tomkooij/Tantillus/Rendering/Tantillus 2.11.jpg

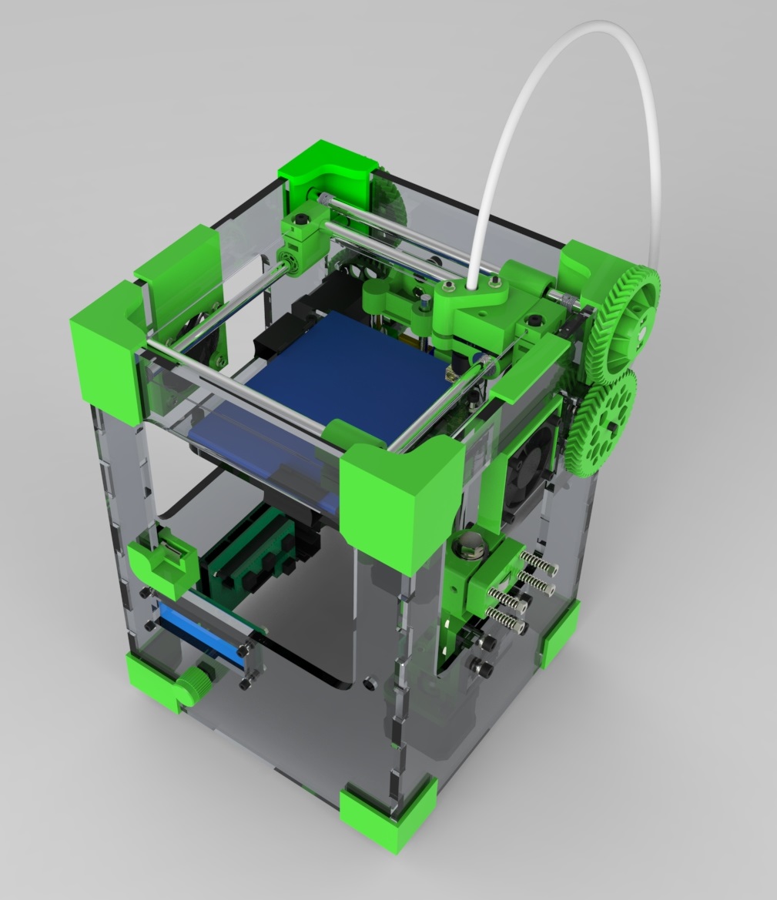
Rendering/Tantillus 2.11.jpg
