tomkooij/Tantillus/Rendering/Tantillus 2.10.jpg

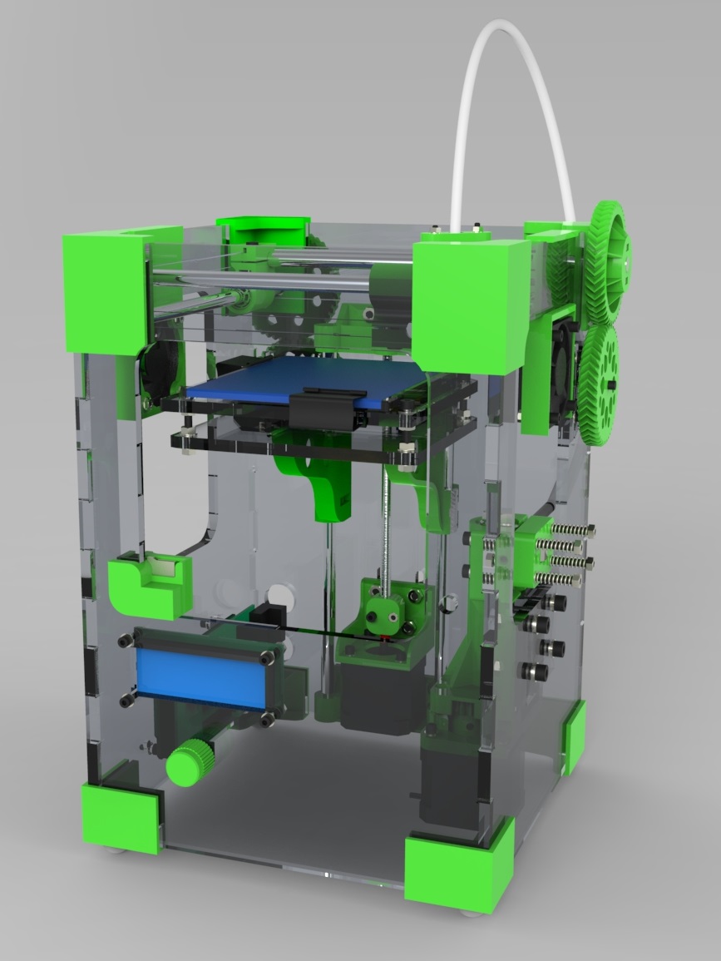
Rendering/Tantillus 2.10.jpg
