tomkooij/Tantillus/README.md

Tantillus
=========

Source and production files for Tantillus 3D Printer Metric edition. By: github.com/willworkforplastic
