tomkooij/Tantillus/READ ME.txt

Tantillus Laser Cutter Metric Edition Solidworks 2012 Model V0.5
See http://www.tantillus.org/ or http://forums.reprap.org/list.php?279 for more info.

*********************************************************************
THIS IS ALWAYS A WORK IN PROGRESS. 
THERE ARE PROBABLY THINGS WRONG WITH HACKED CONFIGS, ALLWAYS CHECK BEFORE USING
THE STANDARD CONFIG HAS BEEN USED MANY TIMES NOW SO IS RELATIVELY SAFE
*********************************************************************

If you print off this model and things are wrong do not blame me!

Check each part for configurations. 

Some parts have 3d print configurations, and laser cutter offset configurations.

Top Level Assembly has display states for removing covers. Also Configurations for various hacks I have done to my machine.
Many configs now through models!

Cheers
Will Work For Plastic
(And Paintballs)

"Living isn't a simple thing" - Everclear

An now for the boring Rev history:

V1.0
X/Y bars now 170mm long were 175mm, to prevent spectra line rubbing
Fixed hot end double up on overall Bom
Removed redundant bulldog clips
Changed nuts in carriage assembly to M3, were M4
Fixed X/Y end STL's so thru hole is actually thru
Changed hex holes in extruder body to 7.5mm were 8/7.2mm

V0.9
Added BOM/Assembly drawings (finally)
Added much more to hacked config (not tested properly yet)
Could not save off an overall hacked version STL (SW crashing when saving off......)

V0.8
Updated Lower Bed Mounting Holes to be in same position as orginal (imperial design) to improve cross compatiblity
Moved position of bull dog clip to avoid one hitting hand on fan when putting on
Moved laser cutting hack files to hack folder to avoid confusion
Added another laser cutting hack file for future heated bed trials

V0.7
Mainly fixed model to be backwards compatible with orginal imperial design
Fixed front pannel bearing pitch mistake (off by 0.25mm)
Increase XY ends shaft hole size to 8.2mm as per orginal design
Tapered wire holes in upper cariage as per orginal design
XY ends updated to new design as per orginal design
Slightly adjusted printed bush dims to match orginal design
Added SD ramps holder hack
Added Voltage/Current meter hack
Added Die Spring Hack
Added missing fastner for Audrino
Drawings to come in next rev

V0.6
Fixed stepper lenght from 48mm to 40mm
Updated bed to be the same as orginal Tantillus design
Added draft to endstop switch
Added representation of bowden tube
Tidied up github repo

V0.5
Fixes as per Sublime Found:
Lower Corners height reduced from 40.5mm to 30.5mm
Updated XY ends to latest rev from Sublime
Updated upper gears to latest rev from Sublime
Changed front pannel fillment hole from 6mm to 8mm
Changed Z-lift to be correct way around and removed redundant plate
Changed Z-axis shaft hole in Z upper bracket from 6mm to 8mm

V0.4
Changed holes in XY ends from 8.2mm to 8.0mm
Added missing features in extruder body
Correct extruder spring posistions
Removed plattern springs
Added Glass and bull dog clips
Added Fans in
Added all gears in supplied by eric (Chur Eric)
Added electronic assembly in supplied by eric (Chur Chur eric)
Completed adding fastners
Fan mount snap hocks profile changed to allow easier snap on
Slight issue with top part of carriage not clamping hot end well. That is blind hole slightly too deep. Reduced clearance.

V0.3 
Intial release into the wild
