tomkooij/Tantillus/Rendering/Tantillus 2.13.jpg

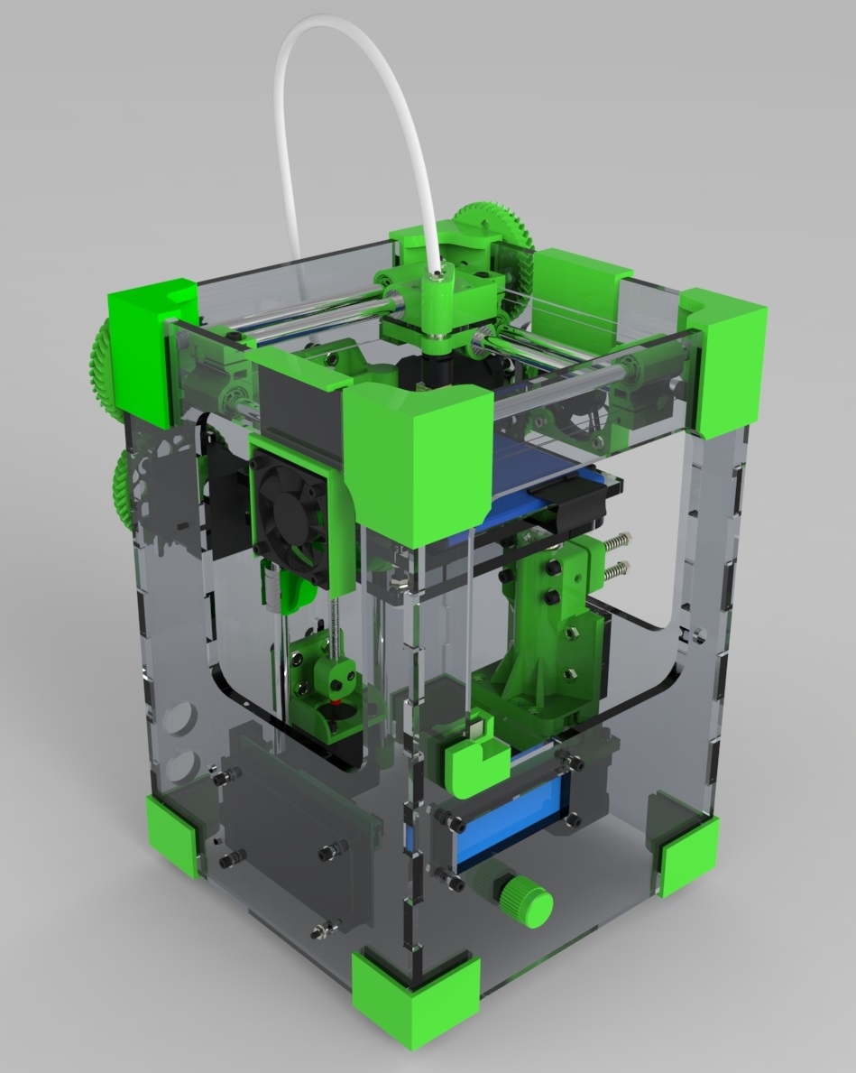
Rendering/Tantillus 2.13.jpg
