tomkooij/Tantillus/Rendering/Tantillus 2.14.jpg

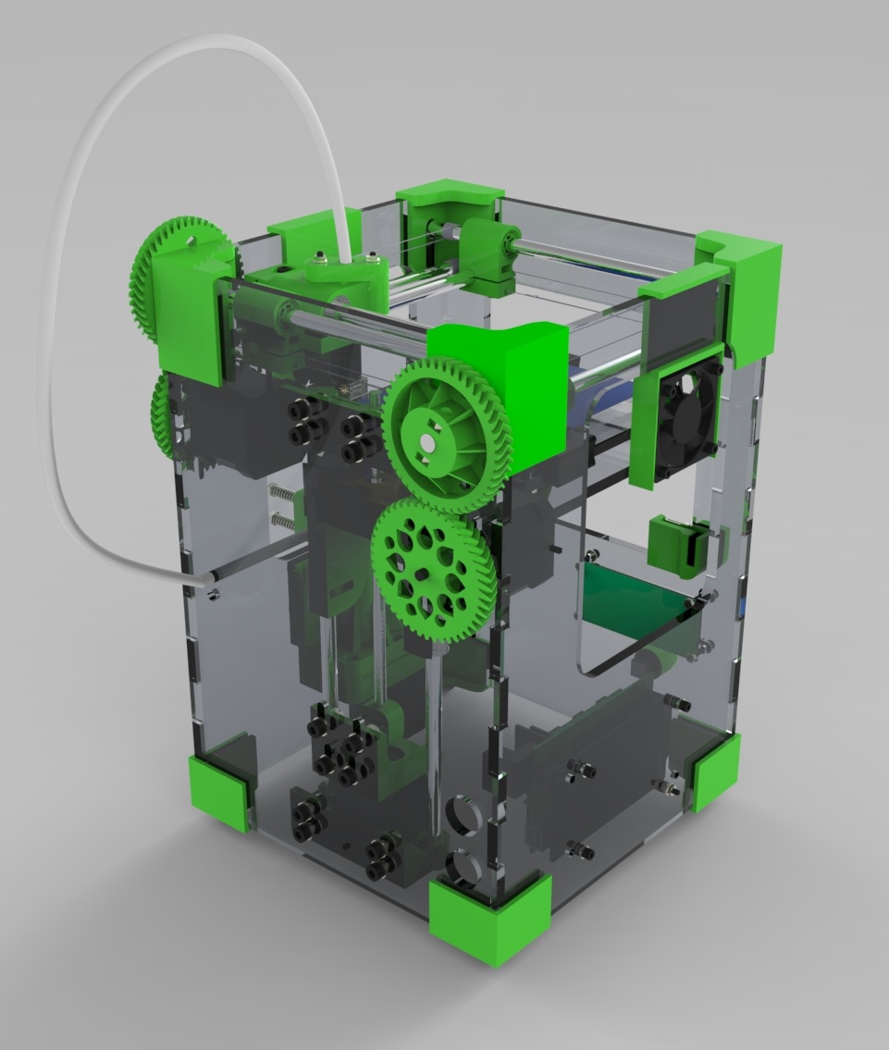
Rendering/Tantillus 2.14.jpg
