tomkooij/Tantillus/Rendering/Tantillus 2.15.jpg

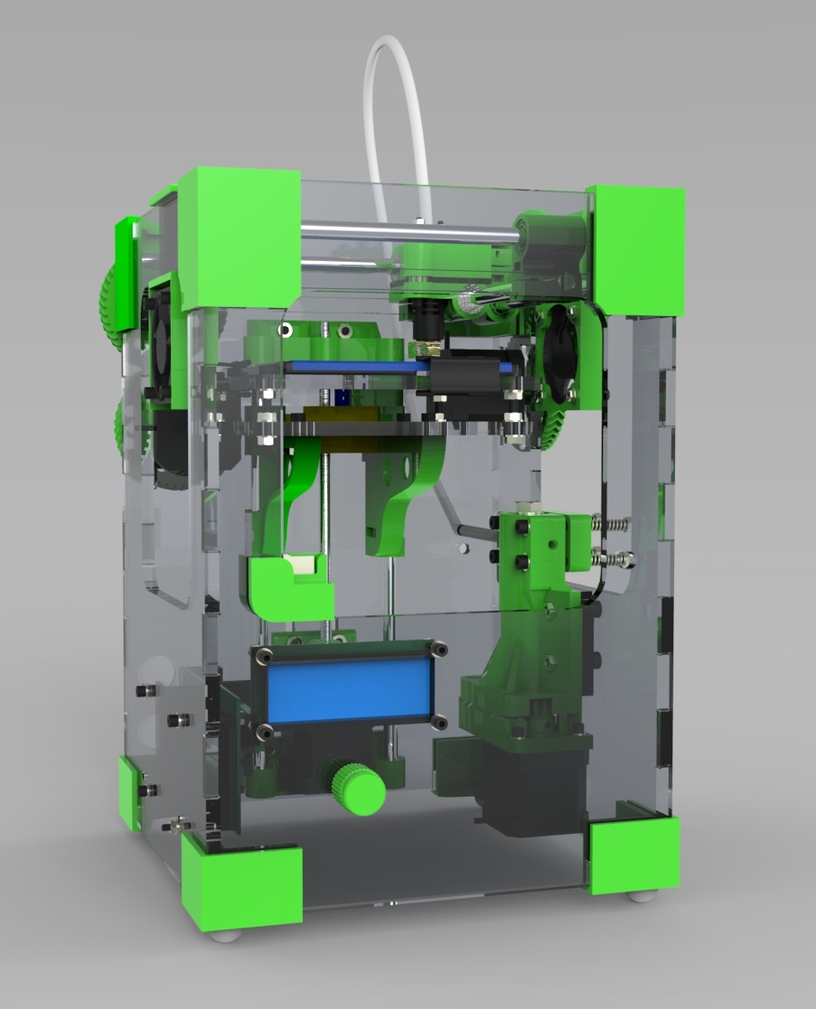
Rendering/Tantillus 2.15.jpg
