tomkooij/Tantillus/Production Files/Axis/XY_end_left.STL

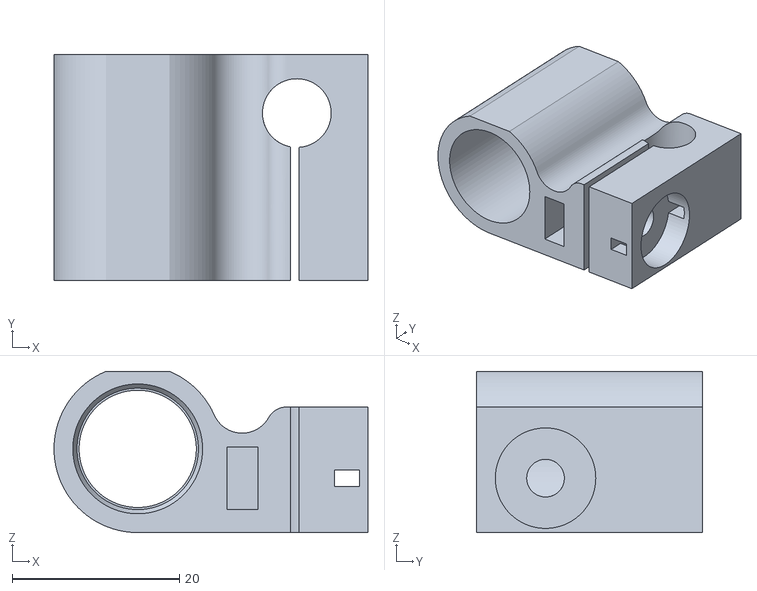
[picture p6: CAD file, 2013-09-08]
Production Files/Axis/XY_end_left.STL
37.5 x 27.0 x 19.3
