tomkooij/Tantillus/Production Files/Corners/Corner_top_rear_right.STL

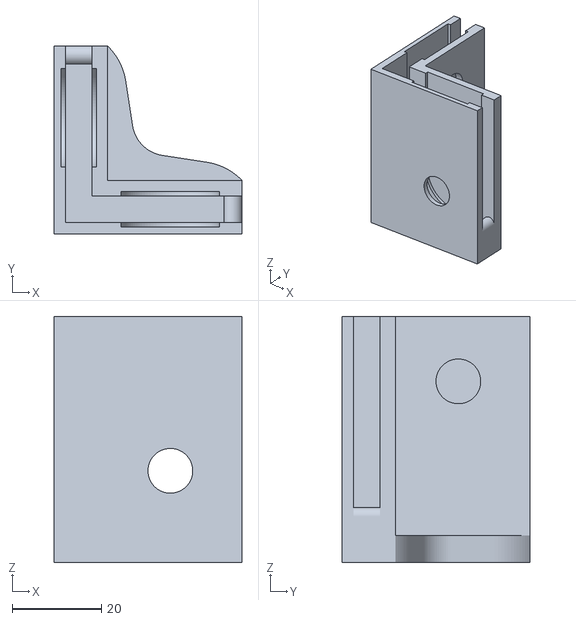
[picture p7: CAD file, 2012-12-14]
Production Files/Corners/Corner_top_rear_right.STL
42.0 x 42.0 x 55.0
