tomkooij/Tantillus/Production Files/Extras/50mm_fanmount_(LC).STL

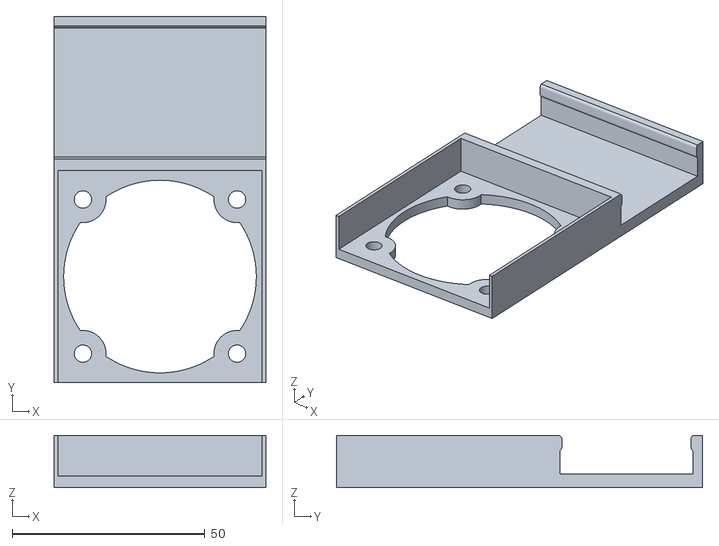
[picture p8: CAD file, 2012-12-14]
Production Files/Extras/50mm_fanmount_(LC).STL
55.0 x 95.0 x 13.5
