tomkooij/Tantillus/Production Files/Extruder/Extruder.STL

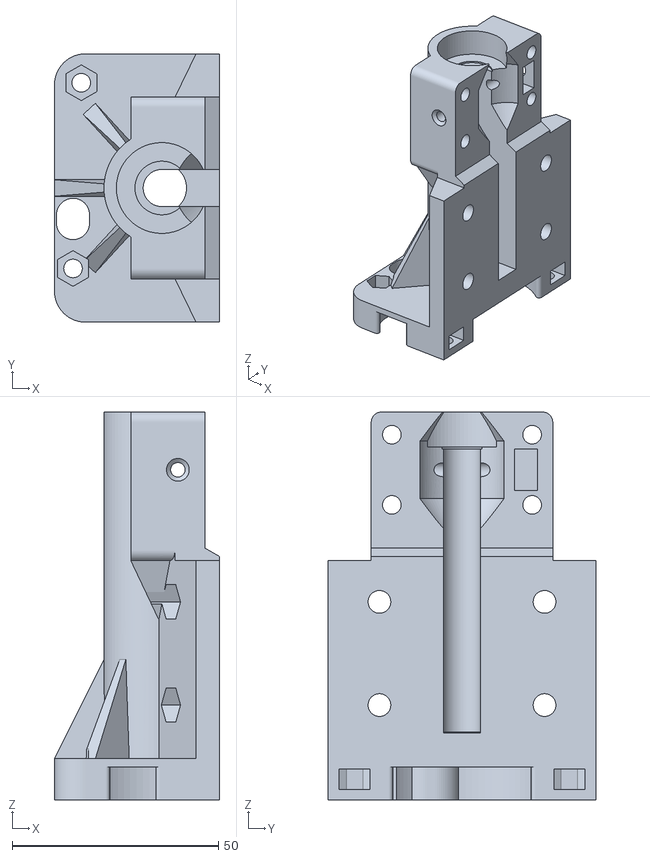
[picture p9: CAD file, 2013-09-08]
Production Files/Extruder/Extruder.STL
40.0 x 65.0 x 94.0
