tomkooij/Tantillus/Production Files/Gears/Upper gear_V2.STL

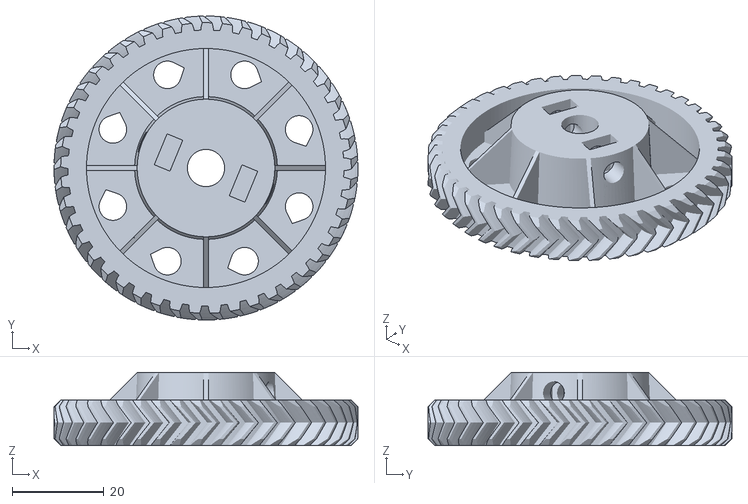
[picture p10: CAD file, 2012-12-14]
Production Files/Gears/Upper gear_V2.STL
66.3 x 66.3 x 16.0
