tomkooij/Tantillus/Production Files/Hacks/SD Card Reader Holder.STL

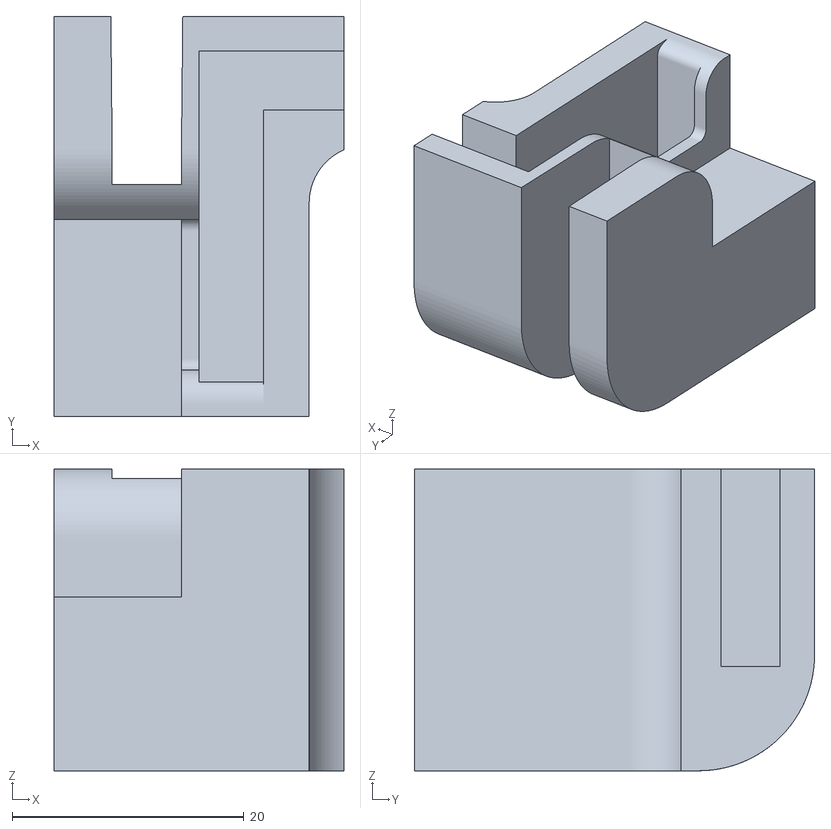
[picture p11: CAD file, 2014-01-19]
Production Files/Hacks/SD Card Reader Holder.STL
25.0 x 34.5 x 26.0
