tomkooij/Tantillus/Production Files/Laser Cutting/All Panels 3mm.DXF

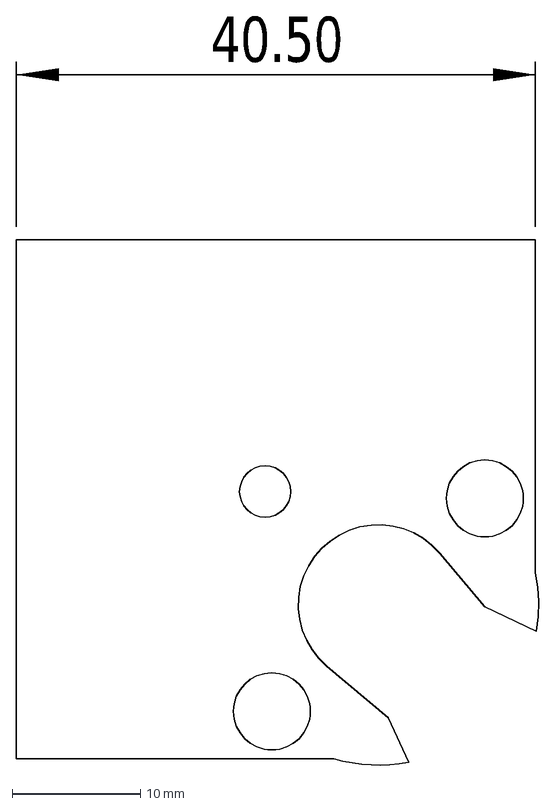
[picture p12: CAD file, 2012-12-14]
Production Files/Laser Cutting/All Panels 3mm.DXF
40.50
