tomkooij/Tantillus/Production Files/Corners/Corner_top_front_left.STL

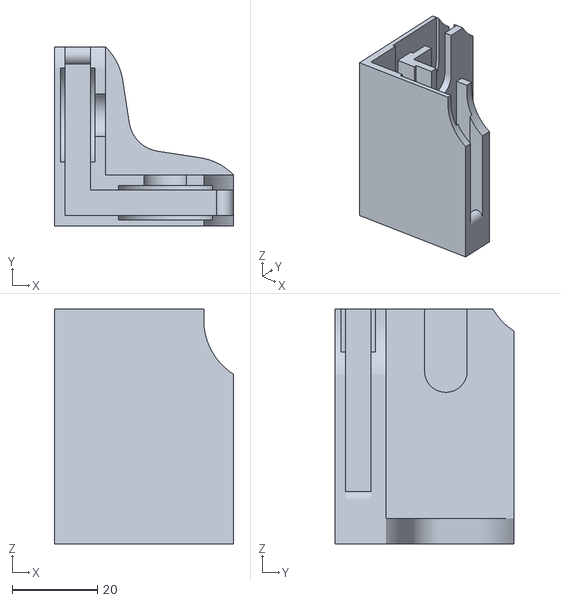
[picture p13: CAD file, 2012-12-14]
Production Files/Corners/Corner_top_front_left.STL
42.0 x 42.0 x 55.0
