tomkooij/Tantillus/Production Files/Extras/Encoder_knob.STL

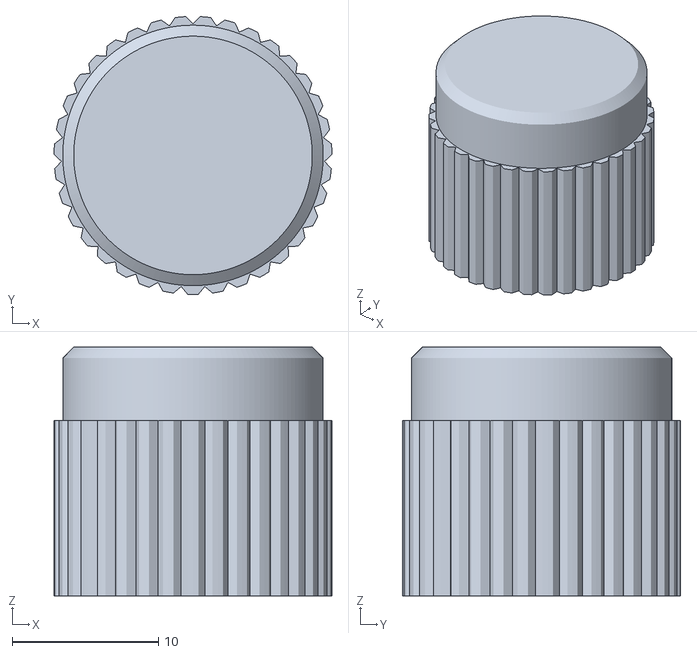
[picture p14: CAD file, 2012-12-14]
Production Files/Extras/Encoder_knob.STL
19.0 x 19.0 x 17.0
