tomkooij/Tantillus/Production Files/Extruder/Extruder_idler.STL

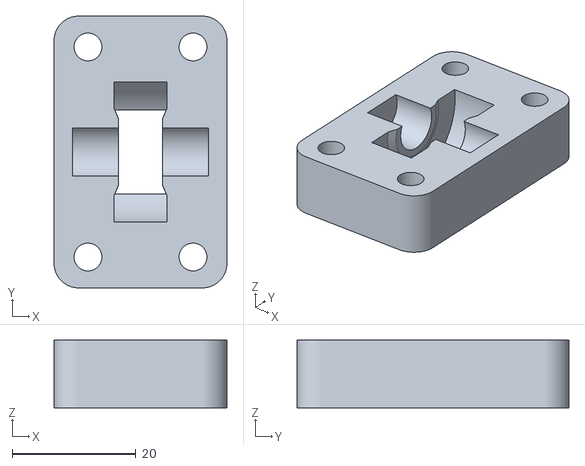
[picture p15: CAD file, 2012-12-14]
Production Files/Extruder/Extruder_idler.STL
28.0 x 44.0 x 11.0
