tomkooij/Tantillus/Production Files/Gears/Motor_Gear_(4mm).STL

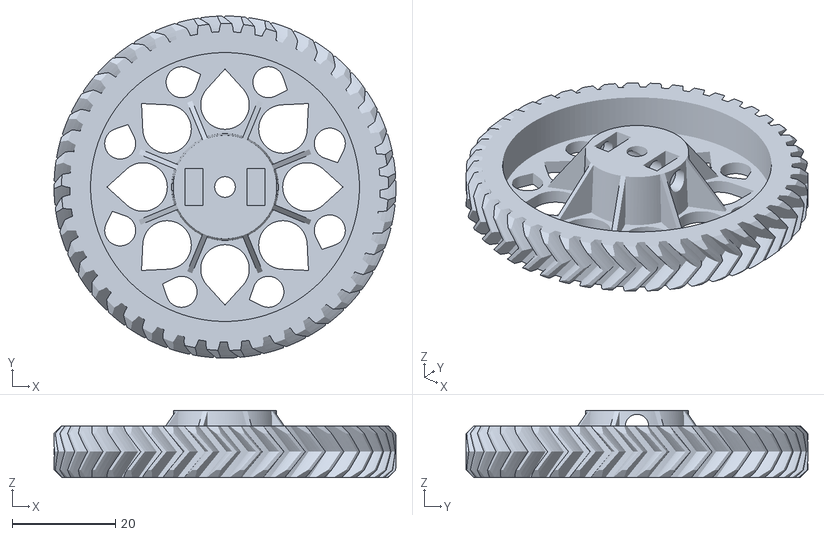
[picture p16: CAD file, 2012-12-14]
Production Files/Gears/Motor_Gear_(4mm).STL
66.3 x 66.3 x 13.0
