tomkooij/Tantillus/Production Files/Hacks/Dry Case Pannels 6mm.DXF

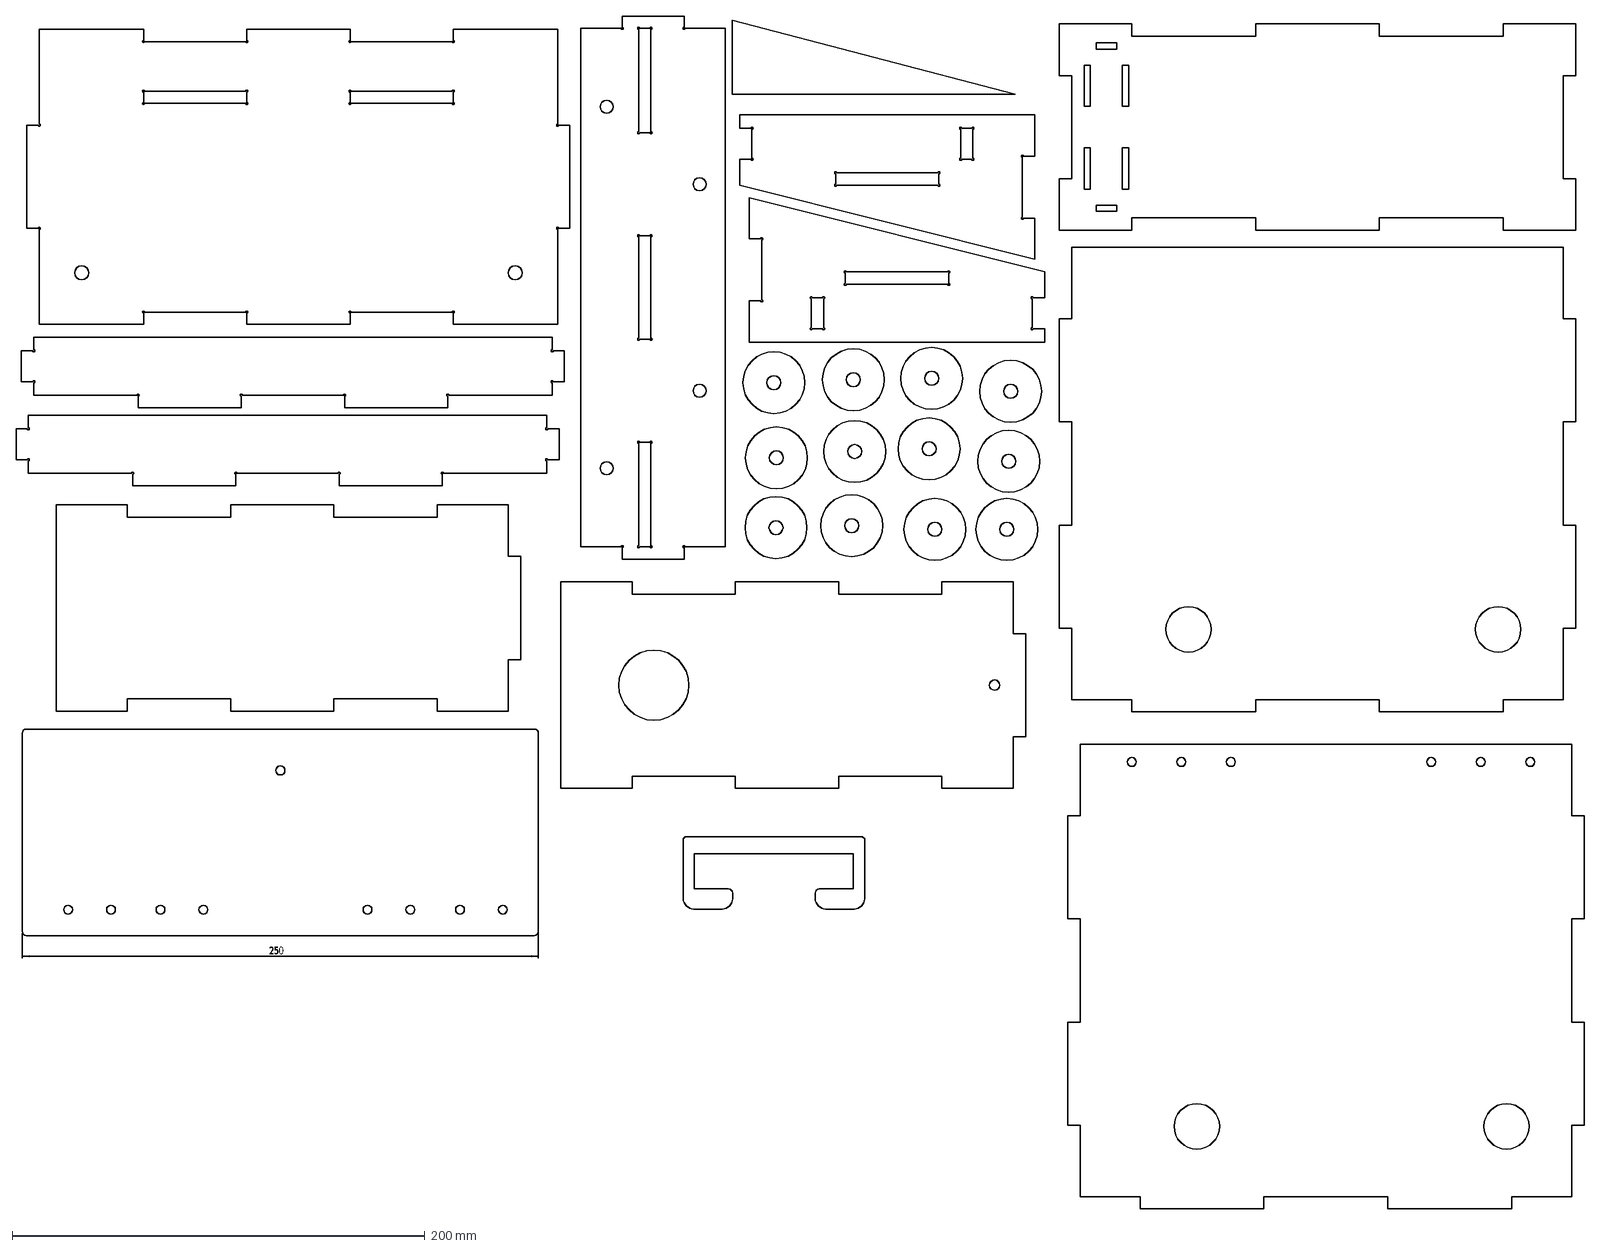
[picture p17: CAD file, 2013-09-08]
Production Files/Hacks/Dry Case Pannels 6mm.DXF
250
