tomkooij/Tantillus/Production Files/Axis/Endstop_holder.STL

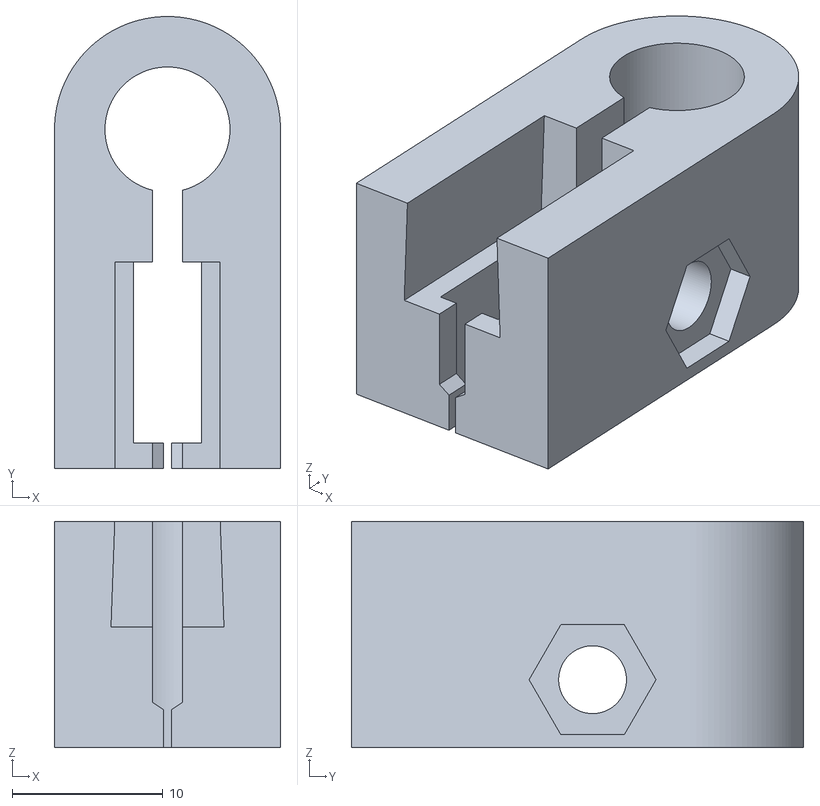
[picture p18: CAD file, 2012-12-14]
Production Files/Axis/Endstop_holder.STL
15.0 x 30.0 x 15.0
