tomkooij/Tantillus/Production Files/Extruder/Extruder_motor_mount_v2.STL

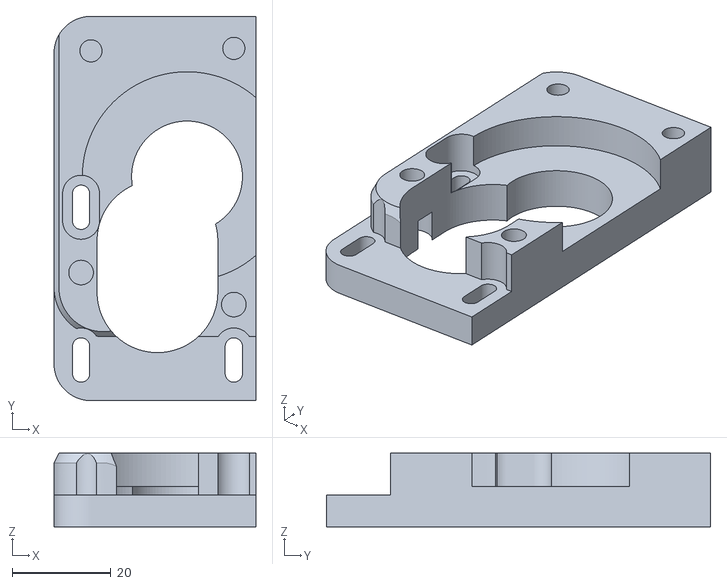
[picture p19: CAD file, 2012-12-14]
Production Files/Extruder/Extruder_motor_mount_v2.STL
41.0 x 78.0 x 15.0
