tomkooij/Tantillus/Production Files/Hacks/Dry Case Pannels 3mm.DXF

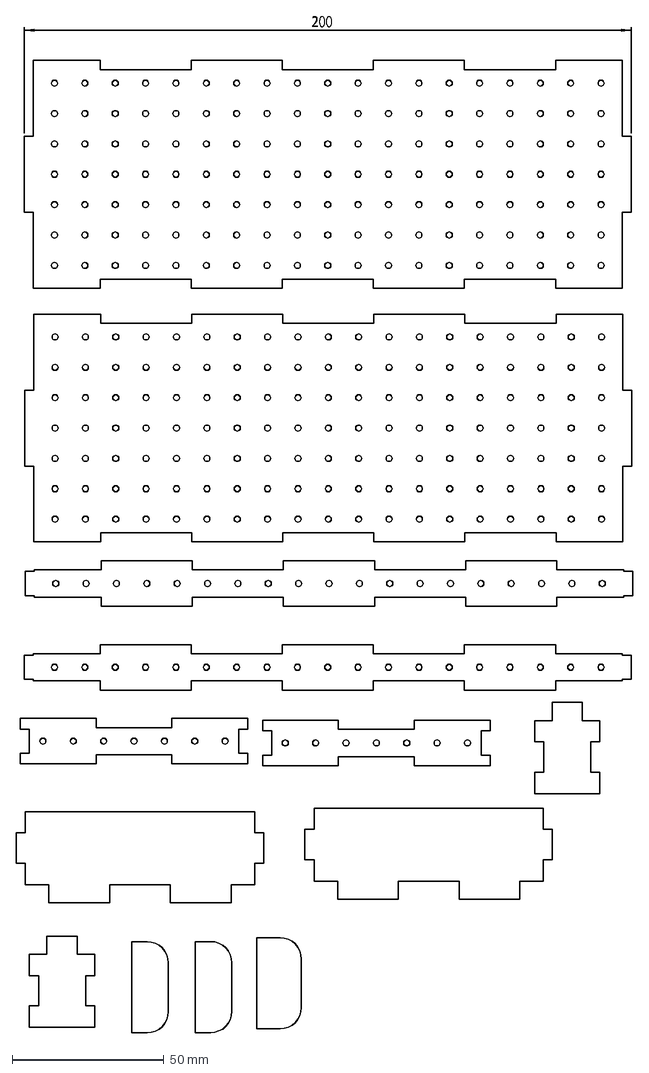
[picture p20: CAD file, 2013-09-08]
Production Files/Hacks/Dry Case Pannels 3mm.DXF
200
