tomkooij/Tantillus/Production Files/Axis/Z_upper_bracket.STL

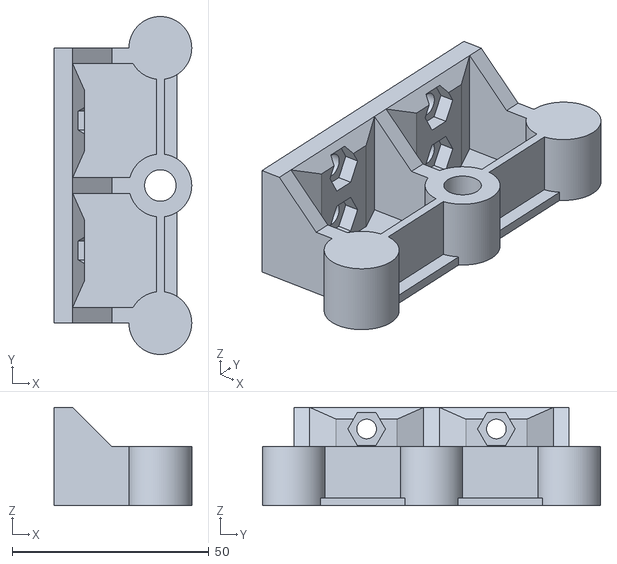
[picture p21: CAD file, 2012-12-14]
Production Files/Axis/Z_upper_bracket.STL
35.0 x 86.0 x 25.0
