tomkooij/Tantillus/Production Files/Corners/Corner_bottom.STL

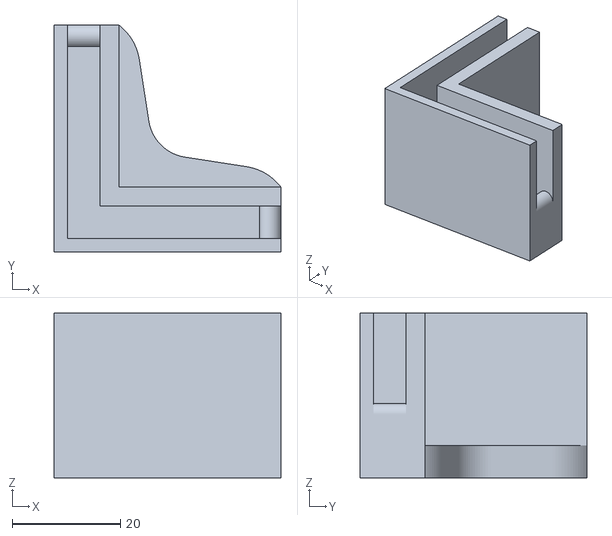
[picture p22: CAD file, 2012-12-14]
Production Files/Corners/Corner_bottom.STL
42.0 x 42.0 x 30.5
