tomkooij/Tantillus/Production Files/Gears/Extruder_small_v2_(5mm).STL

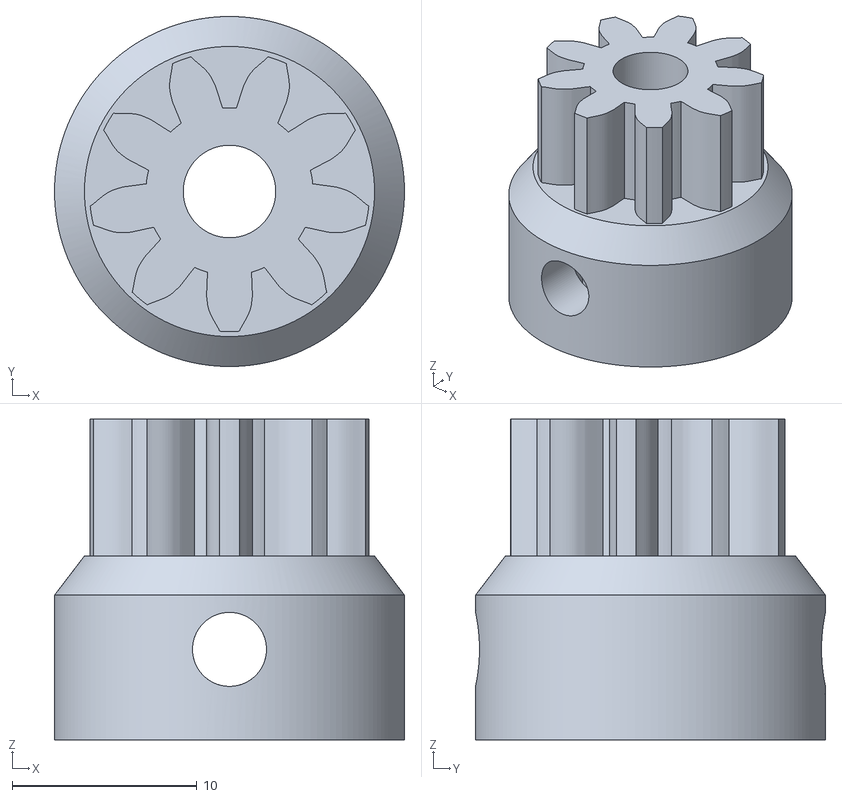
[picture p23: CAD file, 2012-12-14]
Production Files/Gears/Extruder_small_v2_(5mm).STL
18.9 x 18.9 x 17.4
