tomkooij/Tantillus/Production Files/Axis/printable-lm8uu-v3.STL

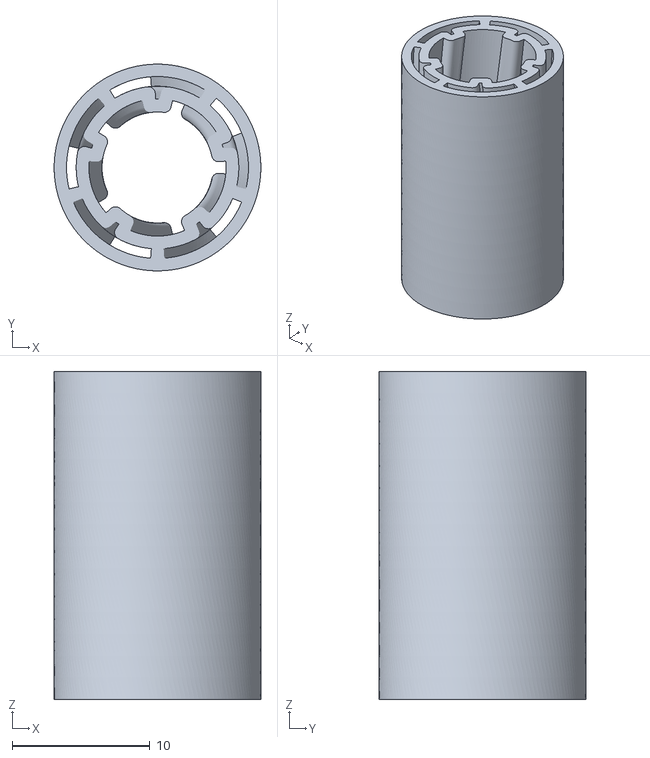
[picture p24: CAD file, 2012-12-14]
Production Files/Axis/printable-lm8uu-v3.STL
15.0 x 15.0 x 23.8
