tomkooij/Tantillus/Production Files/Gears/Extruder_large_v2.STL

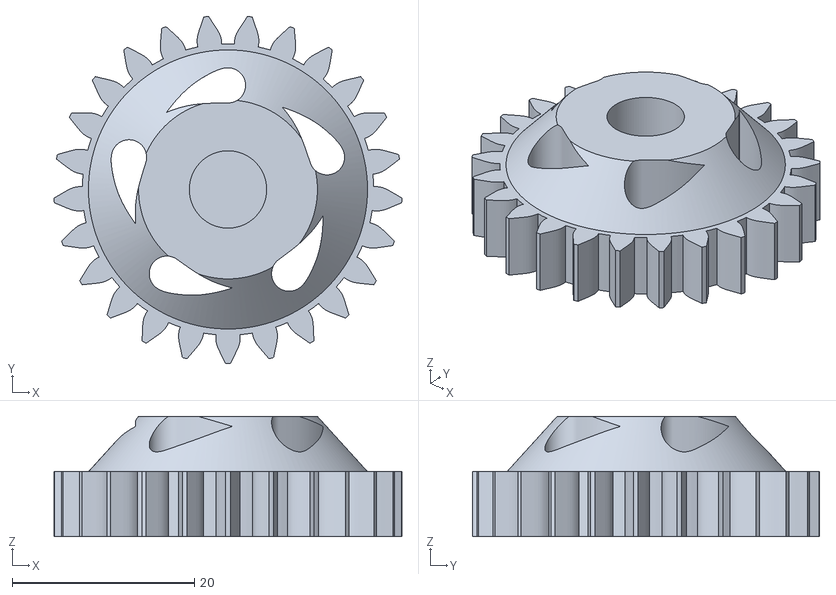
[picture p25: CAD file, 2012-12-14]
Production Files/Gears/Extruder_large_v2.STL
38.2 x 38.2 x 13.2
