tomkooij/Tantillus/Production Files/Axis/Z-coupler.STL

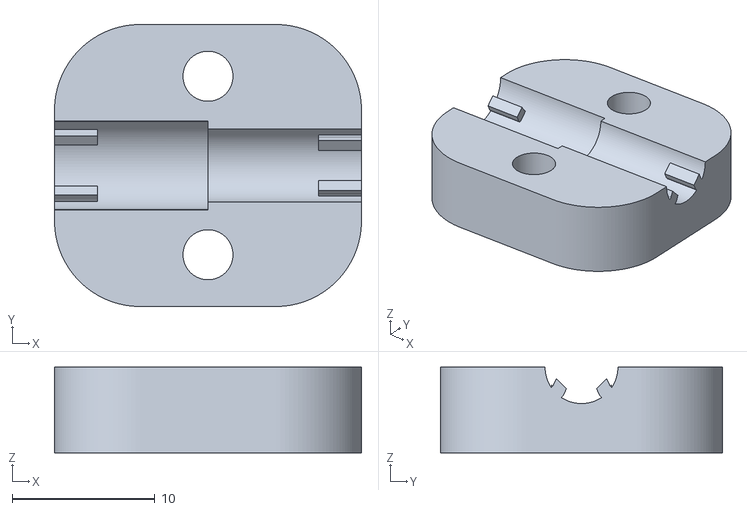
[picture p26: CAD file, 2012-12-14]
Production Files/Axis/Z-coupler.STL
21.5 x 19.8 x 6.00
