tomkooij/Tantillus/Production Files/Axis/Z_lower_bracket.STL

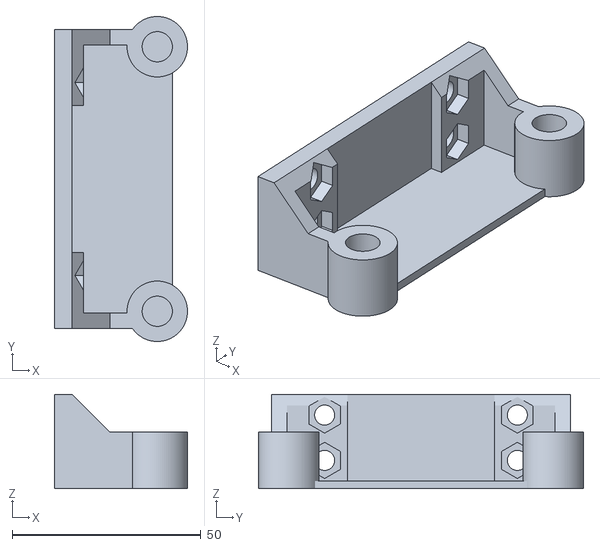
[picture p27: CAD file, 2012-12-14]
Production Files/Axis/Z_lower_bracket.STL
35.2 x 86.0 x 25.0
