tomkooij/Tantillus/Production Files/Axis/Carriage top.STL

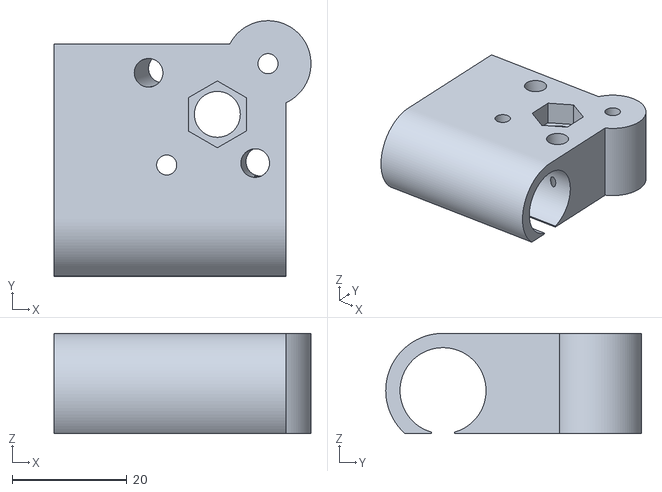
[picture p28: CAD file, 2012-12-14]
Production Files/Axis/Carriage top.STL
44.8 x 44.6 x 17.5
