tomkooij/Tantillus/Production Files/Hacks/XY_end_left_close_fitting.STL

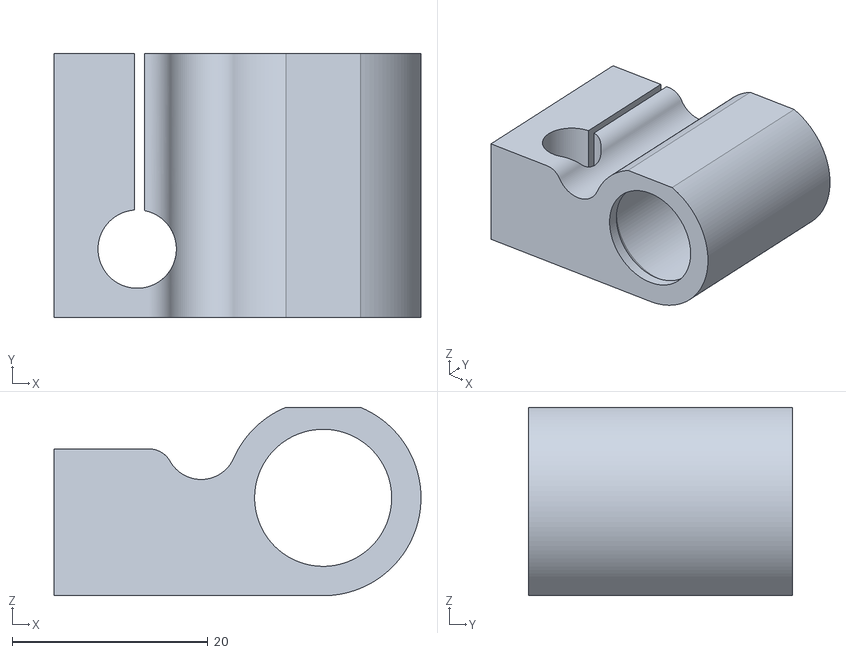
[picture p29: CAD file, 2012-12-14]
Production Files/Hacks/XY_end_left_close_fitting.STL
37.5 x 27.0 x 19.2
