tomkooij/Tantillus/Production Files/Axis/Bowden clamp.STL

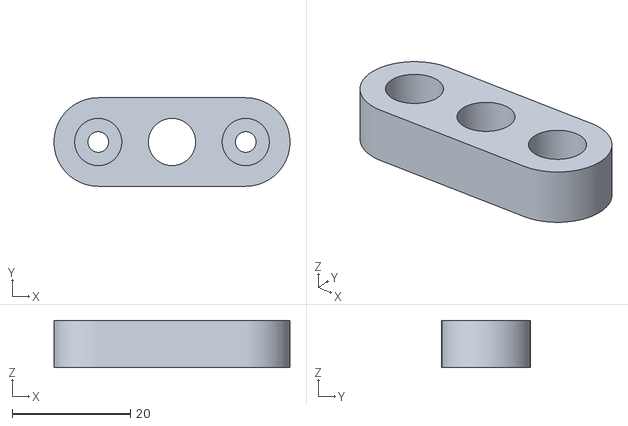
[picture p30: CAD file, 2012-12-14]
Production Files/Axis/Bowden clamp.STL
40.0 x 15.0 x 8.00
