tomkooij/Tantillus/Production Files/Hacks/Cup Die Spring.STL

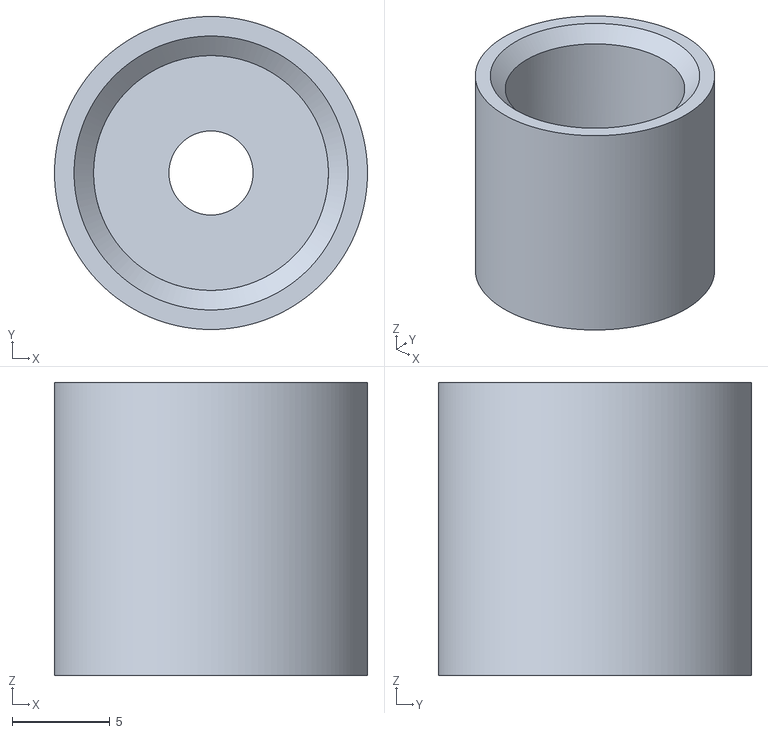
[picture p31: CAD file, 2012-12-14]
Production Files/Hacks/Cup Die Spring.STL
16.0 x 16.0 x 15.0
