tomkooij/Tantillus/Production Files/Axis/Carriage bottom.STL

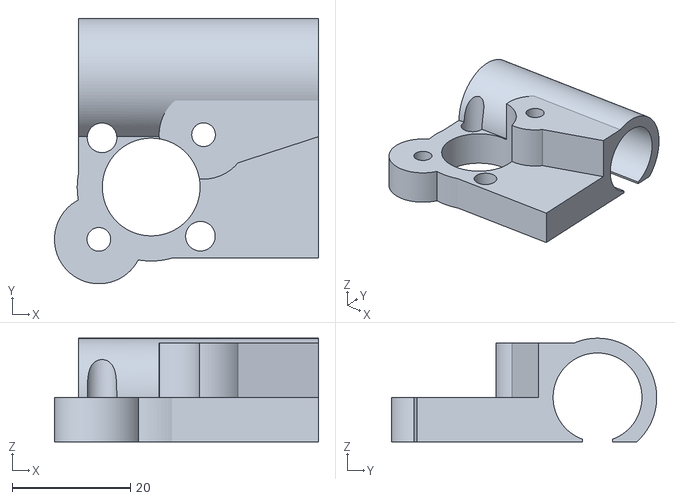
[picture p32: CAD file, 2012-12-14]
Production Files/Axis/Carriage bottom.STL
44.6 x 44.8 x 17.5
