tomkooij/Tantillus/Production Files/Axis/Z_arm_1.STL

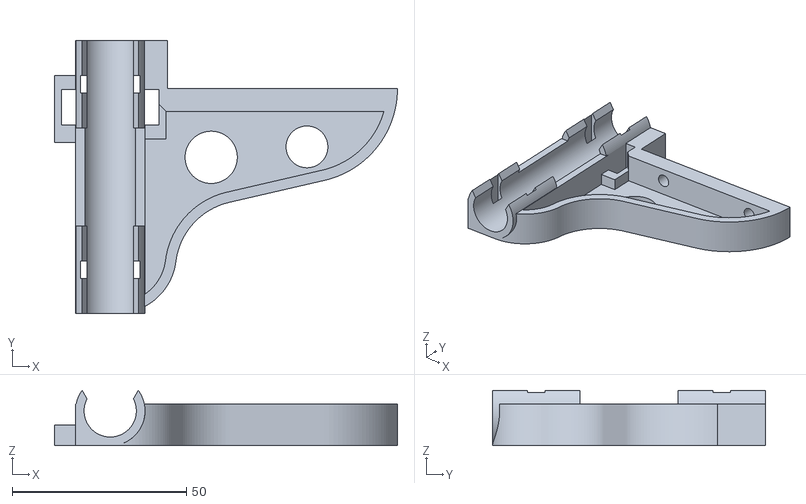
[picture p33: CAD file, 2012-12-14]
Production Files/Axis/Z_arm_1.STL
98.5 x 78.3 x 15.9
