tomkooij/Tantillus/Production Files/Hacks/Extruder_idler_die_spring_hack.STL

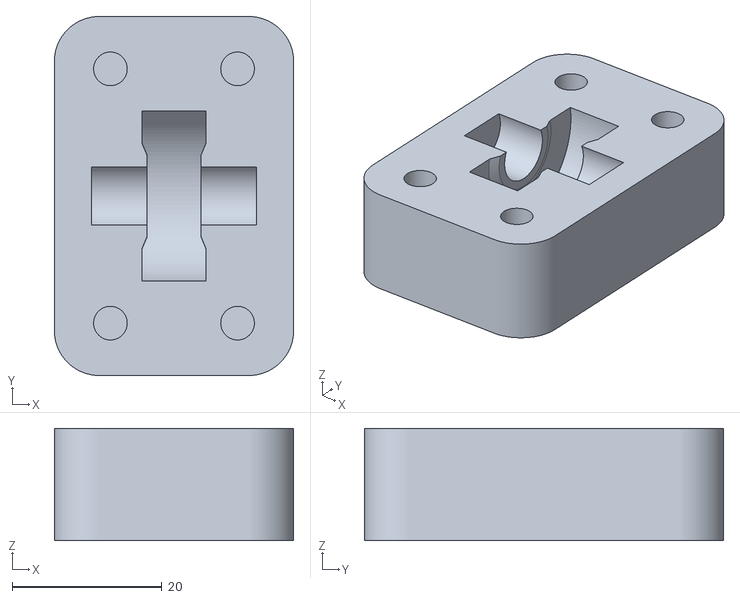
[picture p34: CAD file, 2012-12-14]
Production Files/Hacks/Extruder_idler_die_spring_hack.STL
32.0 x 48.0 x 15.0
