tomkooij/Tantillus/Production Files/Axis/Z_motor_bracket.STL

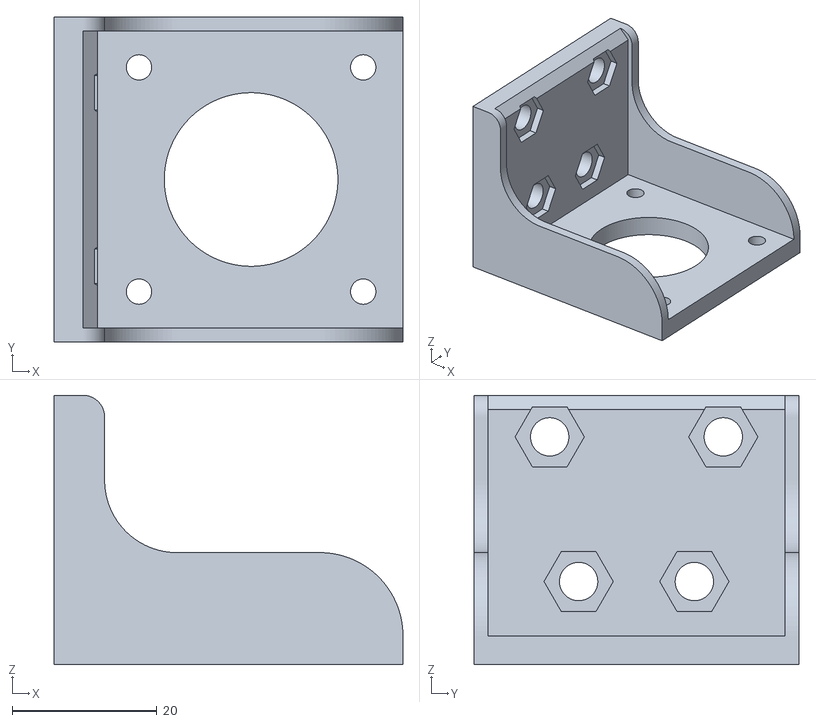
[picture p35: CAD file, 2012-12-14]
Production Files/Axis/Z_motor_bracket.STL
48.2 x 45.0 x 37.2
