tomkooij/Tantillus/Production Files/Axis/Z_lift.STL

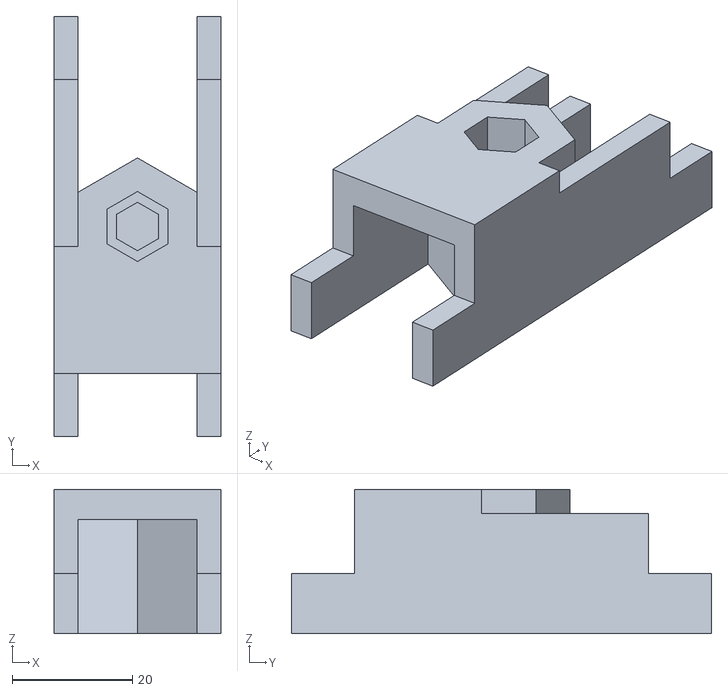
[picture p36: CAD file, 2012-09-30]
Production Files/Axis/Z_lift.STL
27.8 x 70.0 x 24.0
