tomkooij/Tantillus/(list of files, cad)

Other CAD files:
Production Files/Axis/XY_end_right.STL
Production Files/Laser Cutting/All Panels 6mm VLS6_60 0_1mm Offset.DXF
Production Files/Corners/Corner_top_front_right.STL
Production Files/Gears/Motor_Gear_(5mm).STL
Production Files/Laser Cutting/All Panels 6mm.DXF
Production Files/Hacks/All Panels 6mm VLS6_60 0_1mm Offset.DXF
Production Files/Laser Cutting/All Panels 6mm VLS6_60 0_1mm Offset WITH VI METER HACK.DXF
Production Files/Corners/Corner_top_rear_left.STL
Production Files/Hacks/All Panels 6mm VLS6_60 0_1mm Offset WITH VI METER_HEATED BED HACK.DXF
Production Files/Gears/Extruder_small_v2_(4mm).STL
Production Files/Hacks/All Panels 6mm VLS6_60 0_1mm Offset WITH VI METER HACK.DXF
Production Files/Hacks/Z_upper_bracket_close_fitting.STL
Production Files/Hacks/XY_end_right_close_fitting.STL
Production Files/Axis/Z_arm_2.STL
Production Files/Hacks/Upper gear close fitting.STL
