tomkooij/Tantillus/(commit log)

2012-09-23 Trying to remove Duplicates
    [40mm_Fan_duct.blend, 40mm_Fan_duct.stl, 40mm_Fan_mount_(printed case).stl, 40mm_fanmount_(LC).stl, 50mm_fanmount_(LC).stl, All_Fanmounts.blend, All_panels.dxf, All_panels.stl]
2012-09-30 Tidy up, and produciton files
    See read me for changes
    [All Panels 3mm.DXF, All Panels 6mm.DXF, Bowden clamp.STL, Carriage bottom.STL, Carriage top.STL, Corner_bottom.STL, Corner_top_front_left.STL, Corner_top_front_right.STL]
2012-12-14 Backwards compatibly with imperial design
    See readme for all changes, drawings to come in next push.
    [50mm_fanmount_(LC).STL, All Panels 3mm.DXF, All Panels 6mm VLS6_60 0_1mm Offset WITH VI METER HACK.DXF, All Panels 6mm VLS6_60 0_1mm Offset.DXF, All Panels 6mm.DXF, Bowden clamp.STL, Carriage bottom.STL, Carriage top.STL]
2012-12-19 Fix lower bed screw hole position see readme
    [All Panels 6mm VLS6_60 0_1mm Offset WITH VI METER HACK.DXF, All Panels 6mm VLS6_60 0_1mm Offset WITH VI METER_HEATED BED HACK.DXF, All Panels 6mm VLS6_60 0_1mm Offset.DXF]
2013-04-17 Temp Log Added
    Temperature log of MKI heated bed. Both temp distribution and overall
    machine logs are included.
2013-09-08 Incremental Update Please see next Commit
    Having issues with Github so trying a small update first
    [Dry Case Pannels 3mm.DXF, Dry Case Pannels 6mm.DXF, Extruder.STL, XY_end_left.STL, XY_end_right.STL]
2013-09-08 Update including last two commits
    X/Y bars now 170mm long were 175mm, to prevent spectra line rubbing
    Fixed hot end double up on overall Bom
    Removed redundant bulldog clips
    Changed nuts in carriage assembly to M3, were M4
    Fixed X/Y end STL's so thru hole is actually thru
    Changed hex holes in extruder body to 7.5mm were 8/7.2mm
2014-01-19 Added SD Card Holder to Hacks Folder
    [SD Card Reader Holder.STL]
